jerrygeo/uFlow/README.md

# uFlow - Uroflow measurement system
Arduino MKR1010 project to measure peak urinary flow rate and software
to transfer data to a PC via wifi and display results. See Uroflow.pdf.
