jerrygeo/uFlow/PCSoftware/uShow/plot.jpg

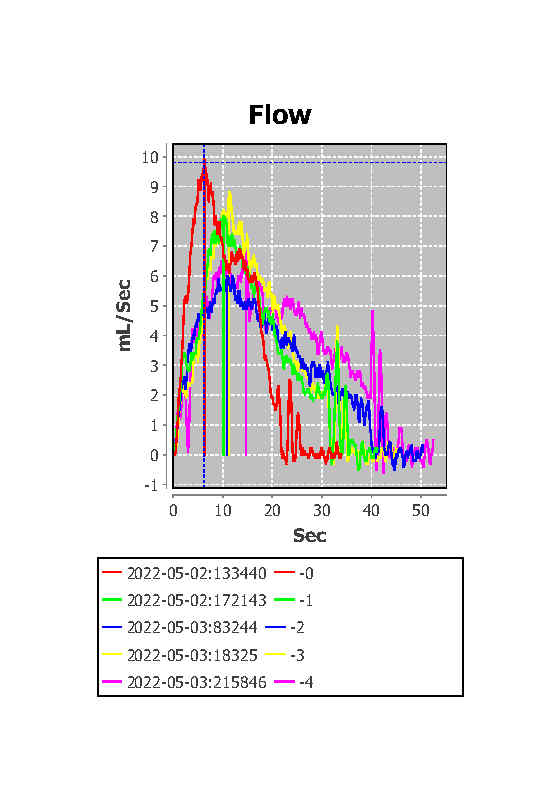
PCSoftware/uShow/plot.jpg
