jerrygeo/uFlow/(threads)

Thread 1 (2022-09-30):

Add license information

vazhnov, 2022-09-30:
Hello!

I found this project from https://hackaday.com/2022/09/29/urine-flow-measurement-made-accessible-with-uroflow/

Could you please add information about the license of this repository — is it allowed to copy, change and use the code and design files in any purpose?
It would be great to see any popular open source license.

jerrygeo, 2022-09-30:
Hello Alexey:

I intended to use the MIT license, which I think means that it is free to use by anyone. I think I declared this license somewhere in Github, but I’m not fluent in the use of Github and forgot where to find the declaration. I’ll look into how to declare it. The licenses for the libraries used are listed in section 3.12 of the PDF document. I had trouble seeing past page 25 of the PDF when I click on the PDF in Github – it might be easier for you to click the green CODE button on the Github site, download the zip, and inspect the PDF file from there.

Thanks for your interest.

Jerry

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
