jerrygeo/uFlow/PCSoftware/uShow/plot.pdf

## Flow

# 10 mL/Sec

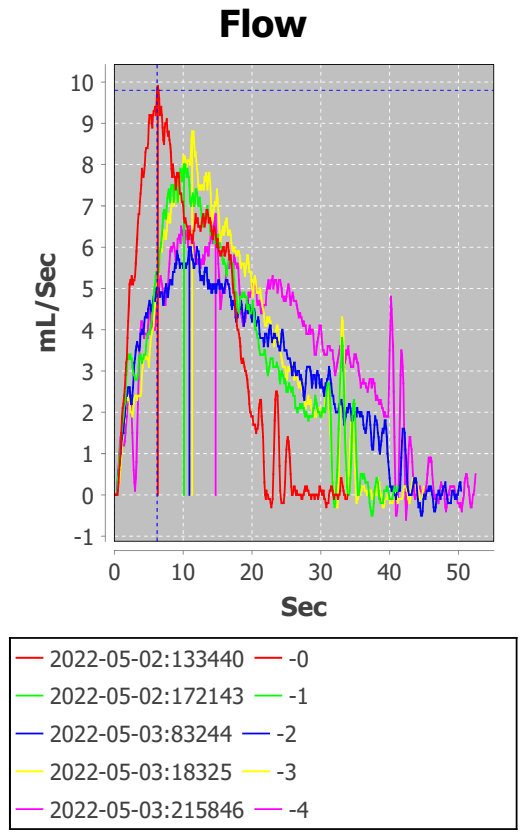
[picture p38: page 1]
Sec
