jerrygeo/uFlow/(list of files, drawings)

Other design files:
PCB/ScaleMkr1010.dch
PCB/ScaleMkr1010revB.dip
