jerrygeo/uFlow/Scalemkr1010/MainStateTask.ino

/*  mainStateTask
 *   
 *   Implement the states as shown in ScaleMKR1010States.odg
 *   
 *   Copyright 2022, Jerry Smith
 */


#include "MainStateTask.h"
#include "Outlier.h"
#include "arduino_secrets.h"
#include "PkPicker.h"

extern struct ConfigStruct uFlowCfg;
struct pkCandidate_ {
  float flow;
  int16_t index;
} pkCandidate;

enum  MainState_  mainState;

// For Wifi connection
///////please enter your sensitive data in the Secret tab/arduino_secrets.h
char ssid[] = SECRET_SSID;        // your network SSID (name)
char pass[] = SECRET_PASS;    // your network password (use for WPA, or use as key for WEP)

int status = WL_IDLE_STATUS;
WiFiServer server(23);
WiFiClient client;
boolean wifiConnected = false;
void doSerialCmd(char *sBuf);

#define NUMBER_OF_ERROR_TYPES 5
String errMsg[] = {
  "wifi module\n",
  "wifi firmware\n",
  "SD card\n",
  "Time base\n",
  " Can't open\n CONFIG.CFG\n  Check SD card"};
  

const int16_t mainTaskRepRate = 100;  // 100msec => 10Hz sampling

const float Qscale = (1.f/10.f)*1000./(mainTaskRepRate*4*7);  // 
      // Qscale accounts for measureBuf being in units of 10*mLs - result is in mLs/sec
      //   See description of derivative() below
COutlier outlier;


unsigned long tTest;

int16_t xCursor;
int16_t yCursor;
unsigned long timeOfLastOutput;
unsigned long timeOfLastMsrmnt;
RtcDateTime measureStartTime;
RtcDateTime measureStopTime;
int16_t measureBufNdx;
int16_t measureBuf[6000]; // Buffer to hold ALL of the collected data in units of 10*mL (6000 samples = 600 seconds, 10 minutes)
//unsigned int timeBuf[500];
//unsigned int timeBuf2[500];
  // Variables for locating position to write on LCD screen
int16_t yVolPosition;
int16_t xVolPosition;
uint16_t wVol, hVol;
int16_t x1Vol, y1Vol;

int16_t mLsTimes10;
int16_t displayed_mLs;
boolean upPressed, downPressed;


  
void mainStateInit() {
   mainState = POWERON;
   timeOfLastOutput = millis();
   measureBufNdx = 20;  // Start at sample 20 in acquireState

}

void stateTransition( MainState_ nextState );  // Need to declare this before defining it due to problem with IDE.
void stateTransition( MainState_ nextState ) {
  mainState = nextState;
  Serial.print("State changed to state ");
  Serial.print(mainState);
  Serial.print("\n");
}


 void powerOnState() {

  tftSplashScreen();
  xCursor = tft.getCursorX();
  yCursor = tft.getCursorY();
  
  mainState = STANDBY;
  if (selfTestError != 0) mainState = ERROR_STATE;
}

void newTFTScreen(int16_t yStart, String tftMsg) {
        tft.fillScreen(ST77XX_BLACK);
        tft.setCursor(0,yStart);
        tft.print(tftMsg);
 }

boolean errMsgDisplayed = false;
void ErrorState(){
    int i;
    int errmsk=1;
    if (!errMsgDisplayed) {
        Serial.print("Entered ErrorState selfTestError=");Serial.print(selfTestError,HEX);Serial.print("\n");
        newTFTScreen(0,"  ERROR\n ");
        for (i=0; i<NUMBER_OF_ERROR_TYPES; i++)
        {
//          Serial.print("errmsk=");Serial.print(errmsk,HEX);Serial.print(" Anded=");Serial.print((selfTestError & errmsk),HEX);Serial.print("\n");
          if ( (selfTestError & errmsk) != 0 ) tft.print(errMsg[i]);
          errmsk = errmsk << 1;
        }
//        Serial.print("Entered ErrorState selfTestError=");Serial.print(selfTestError,HEX);
        errMsgDisplayed = true;
    }
}
void standbyState(struct ButtonStruct localButton) {
  char cbuf[50];
//    if (localButton.WhichKey > 0) {
  if (millis() > timeOfLastOutput+1000) {
      timeOfLastOutput = millis();

//      snprintf(cbuf,sizeof(cbuf), "A1=%d Key=%d Persistance=%d\n",getButtonValue(),localButton.whichKey,localButton.persistence);
//      Serial.print(cbuf);
//      snprintf(cbuf,sizeof(cbuf),"Raw Scale=%u mL=%d\n",scale.read(),scale.get_units());
//      Serial.print(cbuf);

    }
  if (localButton.whichKey == TAREorUP_KEY){ // Transition to TARE state
        newTFTScreen(50," Press UNIT");
        stateTransition(TARE);
        scale.tare();
        Serial.print("\nTare: ");
        Serial.print(scale.get_offset(),DEC);
  }
  if ( localButton.whichKey == WIFI_BUTTON ){
      Serial.print(" Wifi button\n");
      stateTransition(WIFI_CONNECT);
  }
}

void xferState(int localWhichKey) {

}

void tareState(int localWhichKey) {
  if (millis() > timeOfLastOutput+100) {
    timeOfLastOutput = millis();
    Serial.print("Raw Scale = ");
    Serial.print(scale.read(),DEC);
    Serial.print("  mL = ");
    Serial.print(scale.get_units());
    Serial.print("\n");
  }
  if (localWhichKey > 0) {
    if (localWhichKey == NEXTorDOWN_KEY ) {
        scale.set_offset(scale.read());
      if (!getRecalRequest()){
        stateTransition(WAIT_FOR_10ML);
        newTFTScreen(20,"   START\n  FILLING\n\n Press TARE\n to stop");
        measureStartTime = Rtc.GetDateTime();
        timeOfLastMsrmnt = millis();
        tTest = millis();
      }
      else { // Recal requested
        stateTransition(WAIT_FOR_CAL);
        newTFTScreen(50,"  ADD 100mL\n THEN PRESS\n    TARE");
      }
    }
  }
}

void waitFor2mLsState(int localWhichKey) {
  int i;
    timeOfLastMsrmnt = millis();
    mLsTimes10 = scale.get_units();
//Used for test    mLsTimes10 = (timeOfLastMsrmnt - tTest)*5 / 100; // For test, increase 0.5*10 mL each sample
    for (i=0; i<19; i++) {
      measureBuf[i] = measureBuf[i+1];

#ifdef DEBUG
    if (millis() > timeOfLastOutput+1000) {
      timeOfLastOutput = millis();
      Serial.print("mLsTimes10 = ");
      Serial.print(mLsTimes10);
      Serial.print("\n");
      }
#endif
    }
    measureBuf[19] = mLsTimes10;
    if ( mLsTimes10 > 20) {  // Wait for 2mL
       measureBufNdx = 20;
       stateTransition(ACQUIRE);
    }


}

void acquireState(int localWhichKey) {
  int16_t mLsTimes10;
  boolean stopMeasuring = false;
  static boolean stopPressed = false; // This is only reset at power-up

  char cbuf[40];
  

    mLsTimes10 = scale.get_units();
//Used for test    mLsTimes10 = (millis() - tTest)*5 / 100; // For test, increase 0.5*10 mL each sample
    if (measureBufNdx < sizeof(measureBuf)/sizeof(measureBuf[0])) {
//      if (measureBufNdx < sizeof(timeBuf)/sizeof(timeBuf[0])){
//        timeBuf[measureBufNdx] = 0xFFFF & now1;
//        timeBuf2[measureBufNdx] = 0xFFFF & millis();
//      }
      measureBuf[measureBufNdx] = mLsTimes10;
      measureBufNdx++;
    }
    else stopMeasuring = true; // Stop if RAM buffer full
  
  if (localWhichKey == TAREorUP_KEY) stopPressed = true;  // Stop if TARE button pressed
  if (stopPressed && (localWhichKey != TAREorUP_KEY)) stopMeasuring = true;  // Stop when TARE released
  if (stopMeasuring) {
    measureBufNdx--;  // Point to last valid sample
    Serial.print("Final raw Scale = ");
    Serial.print(scale.read(),DEC);
    Serial.print("  mL = ");
    Serial.print(scale.get_units());
    Serial.print(" scale factor: ");
    Serial.print(scale.get_scale()); Serial.print("\n");

    stateTransition(VOLUME_CHECK);
    measureStopTime = Rtc.GetDateTime();
    tft.fillScreen(ST77XX_BLACK);
    tft.setTextSize(1);
    tft.setCursor(0,0);
    tft.print("\n\n    Set Final Volume\n\n");
    tft.print("  TARE=UP   UNIT=DOWN\n\n     WHEN DONE,\n\n   PRESS & HOLD TARE\n\n        " );
    yVolPosition = tft.getCursorY();
    xVolPosition = tft.getCursorX();
    tft.setTextSize(2);
    tft.getTextBounds("999", xVolPosition,  yVolPosition,  &x1Vol,
                      &y1Vol, &wVol,  &hVol);
    displayed_mLs = ( (int)(mLsTimes10/10 + 2)/5) * 5; // mLsTimes10 is in units of 1/10 of a mL. Set to even multiple of 5mL
    tft.print(displayed_mLs);
    Serial.print("BufNdx="); Serial.print(measureBufNdx); Serial.print(" Displayed: ");Serial.print(displayed_mLs); Serial.print("\n");
    }
  }


void volume_checkState(struct ButtonStruct localButton) {
  static boolean upPressed = false;
  static boolean downPressed = false;
  static int tareHoldTime;
  char cbuf[50];

  if (localButton.whichKey == TAREorUP_KEY) {
      upPressed = true;
  }
  else if (upPressed) { 
      if (localButton.whichKey == NO_BUTTONS_PRESSED) { // Only register key when it is released
        displayed_mLs += 5;  // Units of mL - increase by 5mL
        upPressed = false;
        tft.fillRect(xVolPosition, yVolPosition, wVol, hVol, ST77XX_BLACK);
        tft.setCursor(xVolPosition, yVolPosition);
        tft.print(displayed_mLs);
      }
  }
  if ( (localButton.whichKey == TAREorUP_KEY)&& (localButton.persistence >= 2*1000/BUTTON_TASK_REP_RATE) ) {  // If TARE held for 2 sec
        stateTransition(COMPUTE_QMAX);
 #ifdef DEBUG
        Serial.print("Persistence:");
        Serial.print( localButton.persistence);
        Serial.print("\nmeasureBufNdx= "); Serial.print(measureBufNdx);Serial.print("\n");
#endif
    }
    if (localButton.whichKey == NEXTorDOWN_KEY){
      downPressed = true;
    }
    else if (downPressed && (localButton.whichKey == NO_BUTTONS_PRESSED ) ) {
      displayed_mLs -= 5;    // Units of mL - decrease by 5mL
      downPressed = false;
      tft.fillRect(xVolPosition, yVolPosition, wVol, hVol, ST77XX_BLACK);
      tft.setCursor(xVolPosition, yVolPosition);
      tft.print(displayed_mLs);
    }
}

int16_t samples2sec(int16_t count){
  const int16_t samplesPerSecond = 1000/mainTaskRepRate;
  return (count + samplesPerSecond/2)/samplesPerSecond;
}


void StoreData(RtcDateTime logTime,struct SummaryData_ summary ) {
/*!
 *  Function: StoreData
 *  Inputs: 
 *  Outputs: Write data to file SUMMARY.CSV
 *  Description:  SUMMARY.CSV Record Structure (all on one line)
 *       "DATE", Date (in format mm/dd/yyyy),
 *       "TIME", Time (in format hh,mm,ss),
 *       "Qmax", Max flow rate in mL/sec, floating pt, after adjusting total volume
 *       "Tpeak", time in seconds from 10mL level to peak flow, floating pt.
 *       "Ttotal", time in seconds from 10mL level to flow less than 2mL/sec, floating pt.
 *       "Volume", volume in mL, floating pt., before adjusting
  */
  char cbuf[80];
  File SummaryFile;
  File UroFlowFile;
  int i;

  SummaryFile = SD.open("SUMMARY.CSV",FILE_WRITE);
  UroFlowFile = SD.open("UROFLOW.CSV",FILE_WRITE);
  snprintf(cbuf,sizeof(cbuf),"Ver, %4.2f, DATE, %04u-%02u-%02u, TIME,%02u,%02u,%02u,",
            uFlowCfg.swVersion,
            logTime.Year(),
            logTime.Month(),
            logTime.Day(),
            logTime.Hour(),
            logTime.Minute(),
            logTime.Second());
  SummaryFile.print(cbuf);
  UroFlowFile.print(cbuf);
  snprintf(cbuf,sizeof(cbuf),"Qmax, %3.1f, Tpeak, %3.1f, Ttotal, %3.1f,  ",
            summary.Qmax,
            summary.maxNdx*(mainTaskRepRate/1000.),
            summary.endT*(mainTaskRepRate/1000.) );
  SummaryFile.print(cbuf);
  UroFlowFile.print(cbuf);
  snprintf(cbuf,sizeof(cbuf), "Volscale, %d, Volvisual, %d, Calib, %d\n",
            summary.finalVolume,
            summary.visualVolume,
            summary.strainGaugeScale );
  SummaryFile.print(cbuf);
  UroFlowFile.print(cbuf);
  for (i=0; i<measureBufNdx-5; i++) {
    float deriv = ( i>=5 )? derivative(&measureBuf[i]) : 0. ;
    snprintf(cbuf,sizeof(cbuf),"%5.1f, %5.1f, %5.1f, %5.1f\n",
                 i*0.1, 
                 measureBuf[i]*0.1,
                 outlier.originalData(measureBuf, i)* 0.1, 
                 deriv );
    UroFlowFile.print(cbuf);
  }
  UroFlowFile.print("\n"); // Add a blank line to easily jump between sessions in Excel
  SummaryFile.close();
  UroFlowFile.close();
}

float derivative( int16_t *bufptr ) {
/*************************************************
 *  Function: derivative ( int16_t *bufptr )
 *  Inputs:   bufptr - pointer to point in buffer where 
 *                     derivative is to be evaluated
 *     Globals:  Qscale - scale factor for flow rate
 *  Outputs:     Returns estimate of derivative.
 *  Description: Fluid volume data is stored with a precision of .1mL.
 *               If we formed the derivative from x[i]-x[i-1], the flow rate
 *               would suffer a maximum quantization error of +/-.5mL/.1sec = +/-1mL/sec.
 *               So, we average this estimate of the derivative over 4 samples:
 *               Delta = 1/4*( x[i-1]-x[i-2] + x[i]-x[i-1] + x[i+1]-x[i] + x[i+2]-x[i-1] )
 *                     = 1/4 * ( x[i+2] - x[i-2]  )
 *               This estimate reduces the maximum quantization error to  +/-.25mL/sec
 *               However, there were periodic fluctuations in the derivative measurements
 *               with a period of 6 - 7 samples. I think these fluctuations are due to 
 *               waves on the fluid surface. So, the above estimate is averaged over 7
 *               samples, resulting in the computation below. 
 *************************************************/
  return ( (*(bufptr+5) - *(bufptr-2) +
           *(bufptr+4) - *(bufptr-3) +
           *(bufptr+3) - *(bufptr-4) +
           *(bufptr+2) - *(bufptr-5) )* Qscale );
}
/*************************************************
 *  Function: computeQMaxState ( int whichKey )
 *  Inputs:   whichKey - button pressed
 *     Globals:  measureBuf - array of samples in units of mL*10
 *               measureBufNdx - index of last data
 *               displayed_mLs - volume measured by user from graduated beaker (in mL, rounded to nearest 5mL)
 *  Outputs:     measureBuf - corrected if necessary based on displayed_mLs.
 *               duration - time from .1 to .9 of max volume
 *               qMax - maximum flow rate
 *               uFlow.dat file updated - see writeDataFile for file structure
 *  Description: Note: This state hogs the processor until it needs user input from the buttons.
 *               If final volume is more than 5mL away from displayed_mLs, scale 
 *                 Qmax by displayed_mLs/finalVolume, with rounding
 *************************************************/
void computeQMaxState(int whichKey) {
  struct SummaryData_ Summary;
  int16_t i;
  int16_t startNdx=0;
  int16_t j;
  float rescale;  // Factor to adjust volume data based on visual check 
  float flowRate;
  long sum;  // Used to average last 10 samples
  char cbuf[80];
  boolean foundEnd = false;
  boolean foundStart = false;

  CPkPicker pkPicker;
    // Remove outliers
  outlier.removeOutliers(measureBuf, measureBufNdx);
  Summary.strainGaugeScale = uFlowCfg.strainGaugeScale;
    // Load Summary structure with known data
  Serial.print("Scale factor: ");Serial.print(Summary.strainGaugeScale);Serial.print("\n");
  Summary.finalVolume = measureBuf[measureBufNdx];
  Summary.visualVolume = displayed_mLs;
  for (int i=0; i<measureBufNdx; i++) {
    Serial.print("  "); Serial.print(measureBuf[i]);
    Serial.print("  "); Serial.print(outlier.originalData(measureBuf, i));
//    if (i<sizeof(timeBuf)/sizeof(timeBuf[0])){
//      snprintf(cbuf,sizeof(timeBuf)/sizeof(timeBuf[0]),", %d, %d",timeBuf[i],timeBuf2[i]);
//      Serial.print(cbuf);
//    }
    Serial.print("\n");
  }  
      // Search for maximum derivative
  Summary.maxNdx = 1;
  Summary.Qmax = 0.f;
  Summary.endT = 0.f;
  for (i=5; i<=measureBufNdx-5; i++) { // Find index of maximum derivative
      flowRate = derivative ( &measureBuf[i] );
      pkPicker.qualify(flowRate,i,Summary);  // Update Summary when peak qualifies
     if ( !foundStart && (measureBuf[i] > 2*10) ) { // Start when volume > 2mL in units of 0.1mL
      foundStart = true;
      startNdx = i;
      Summary.startT = i;
      Serial.print("startT = "); Serial.print(i); Serial.print("\n");
     }
     if (foundStart && !foundEnd && (flowRate < 2.)){
        Summary.endT = i - startNdx ;
        foundEnd = true;
       }
  }
  Summary.maxNdx -= startNdx;
  Summary.rescale = 1.0;
    // If last measurement is more than 5mL away from corrected measurement, rescale the Qmax
  if ( abs(Summary.finalVolume - displayed_mLs*10) > 50 ) { // measureBuf is in units of mL*10, but displayed_mLs is in units of mL. 
    Summary.rescale = (float)(displayed_mLs*10.) / (float) Summary.finalVolume;
    Summary.Qmax = Summary.Qmax*Summary.rescale;  
    }
  snprintf(cbuf,sizeof(cbuf)-1,"Max: %4.1f measureBuf[%d] = %d\n",Summary.Qmax,Summary.maxNdx,measureBuf[Summary.maxNdx+startNdx]);
  Serial.print(cbuf);
  snprintf(cbuf, sizeof(cbuf)-1,"\nendT = %d + %d, measureBuf= %d\n",Summary.endT, startNdx,  measureBuf[Summary.endT+startNdx]);
  Serial.print(cbuf);
  sum = 0;
//  Serial.print("Final samples:\n  ");
    for (i=measureBufNdx-9; i<=measureBufNdx; i++){
      sum += measureBuf[i];         
//    Serial.print(measureBuf[i]); Serial.print("\n  ");
    }

  Summary.finalVolume = round(sum/(10*10.)); // volume stored in units of 1/10 mL
  Serial.print("Final Volume: "); Serial.print(Summary.finalVolume);
  StoreData(timeAtStart, Summary);
  snprintf(cbuf,sizeof(cbuf)-1,"\n Qmax:%4.1f\n V: %4d mL\n T:%3d,%3d\n    DONE\n  TURN OFF",
               Summary.Qmax,
               Summary.finalVolume,
               samples2sec(Summary.maxNdx), 
               samples2sec(Summary.endT) );
  newTFTScreen(0,cbuf);
  stateTransition(POWER_OFF);
}

void recalState() {
  long rawReading;
  int16_t newScaleFactor;
  char cbuf[40];
  
  rawReading = scale.read_average(5); // Average of 5 readings
  snprintf(cbuf, sizeof(cbuf)-1, "Raw reading = %d\n",rawReading);
  Serial.print(cbuf);
  newScaleFactor = ( rawReading - scale.get_offset() ) / 1000l;  // 100mL in units of 0.1mL
  setScaleFactor(newScaleFactor);   // Update uflowCfg
  snprintf(cbuf, sizeof(cbuf)-1, "New scale factor = %d\n",newScaleFactor);
  Serial.print(cbuf);
  writeCfg(uFlowCfg);
  setRecalRequest(false);
  newTFTScreen(0,"\n\n    DONE\n\n  TURN OFF");
  stateTransition(POWER_OFF);
}

void printWifiStatus() {
  char cbuf[60];
  int i;
  // print the SSID of the network you're attached to:
  Serial.print("SSID: ");
  Serial.println(WiFi.SSID());

  // print your board's IP address:
  IPAddress ip = WiFi.localIP();
  Serial.print("IP Address: ");
  Serial.println(ip);

  // Display IP address on TFT
  snprintf(cbuf,60,"\n   Connect\n     to\n  %d.%d.\n   %d.%d",ip[0],ip[1],ip[2],ip[3]);
  newTFTScreen(0,cbuf);
  
  // print the received signal strength:
  long rssi = WiFi.RSSI();
  Serial.print("signal strength (RSSI):");
  Serial.print(rssi);
  Serial.println(" dBm");
}

void wifiConnectState( void ){

  char sBuf[20];
  int sBufNdx = 0;
  int nAttempts = 0;

  // attempt to connect to WiFi network:
  while (status != WL_CONNECTED) {
    Serial.print("Attempting to connect to SSID: ");
    Serial.println(ssid);
    // Connect to WPA/WPA2 network. Change this line if using open or WEP network:
    status = WiFi.begin(ssid, pass);
    newTFTScreen(0,"\n\n Trying to\n  Connect\n    ");
    tft.print(nAttempts++);
    // wait 5 seconds for connection:
    delay(5000);
  }
  // start the server:
  server.begin();
  // you're connected now, so print out the status:
  printWifiStatus();
  stateTransition(WIFI_CONNECT);

  while (true) {  // Do forever
  // wait for a new client:
     client = server.available();


  // when the client sends the first byte, say hello:
    if (client) {
      if (!wifiConnected) {
        // clear out the input buffer:
        client.flush();
        Serial.println("We have a new client");
        client.print('>');
        wifiConnected = true;
      }

      if (client.available() > 0) {
        // read the bytes incoming from the client:
        sBuf[sBufNdx] = toupper(client.read()); 
        // echo the bytes back to the client:
        // server.write(thisChar);
        // echo the bytes to the serial port as well:
        Serial.write(sBuf[sBufNdx++]);
      }
      if ( (sBufNdx > 0) && ( (sBuf[sBufNdx-1] == '\n')|| (sBufNdx >= sizeof(sBuf)) ) )  {
        doSerialCmd(sBuf);
        sBufNdx = 0;
      }
    }    
  }
}

/***********************
 *    void mainStateDispatch()
 *    
 *    Take action for the current state
 */
void mainStateDispatch() {
    ButtonStruct thisButton;
    thisButton = getButton();
    if (thisButton.whichKey == WIFI_BUTTON){
      Serial.print("Button value: ");Serial.print(getButtonValue());
      stateTransition(WIFI_CONNECT);
    }
       // Note - system sticks in WIFI_CONNECT state and hogs the processor - no other tasks will run.
    switch (mainState)
    {     // Most mainStates only care about when a button has changed, but
          //  VOLUME_CHECK state needs to see how long it has been held down.

      case POWERON: powerOnState();
           break;
      case STANDBY: standbyState(thisButton);
           break;
      case WIFI_CONNECT: wifiConnectState();
           break; // Note - system sticks in WIFI_CONNECT state and hogs the processor - no other tasks will run.
      case XFER: xferState(thisButton.whichKey);
             break;
      case TARE: tareState(thisButton.whichKey);
           break;
      case WAIT_FOR_10ML: waitFor2mLsState(thisButton.whichKey);
           break;
      case ACQUIRE: acquireState(thisButton.whichKey);
           break;
      case VOLUME_CHECK: volume_checkState(thisButton);
           break;
      case COMPUTE_QMAX: computeQMaxState(thisButton.whichKey);
           break;
      case WAIT_FOR_CAL: if (thisButton.whichKey == TAREorUP_KEY) {
            stateTransition(RECAL_STATE);
            }
            break;
      case RECAL_STATE: recalState();
           break;
     case POWER_OFF:  // Do nothing - wait for power to be turned off
           break;
     case ERROR_STATE: ErrorState();
           break;
      }
}


void mainStateTask() {

    digitalWrite(19, (digitalRead(19) ^ 1) ); // Toggle pin 19 (A4) to see timing on a scope
    mainStateDispatch();
//    tasks.now(mainStateRestart);
   tasks.after(mainTaskRepRate,mainStateTask);
  }
  
