jerrygeo/uFlow/(commit log)

2022-08-14 Editorial corrections
    Clean up document; Update some code comments
    [ConfigHandler.ino]
2022-08-15 Update description
    Move arrows in photos; describe removing 5th screw on top of scale.
2022-08-15 Correct flow quantization analysis
    Correct analysis of flow quantization error in uroflow.docx
